R-Mutura/GPS_MODULE_ECOBODA/IMAGES/1 GPS_MODULE_V3.kicad_pro.png

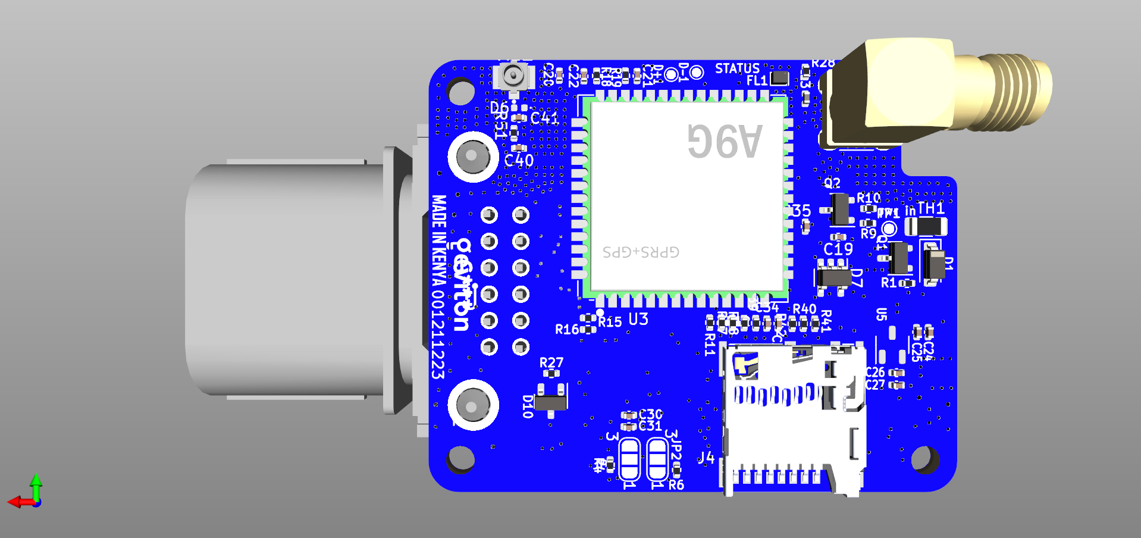
IMAGES/1 GPS_MODULE_V3.kicad_pro.png
