R-Mutura/GPS_MODULE_ECOBODA/IMAGES/2 GPS_MODULE_V3.kicad_pro.png

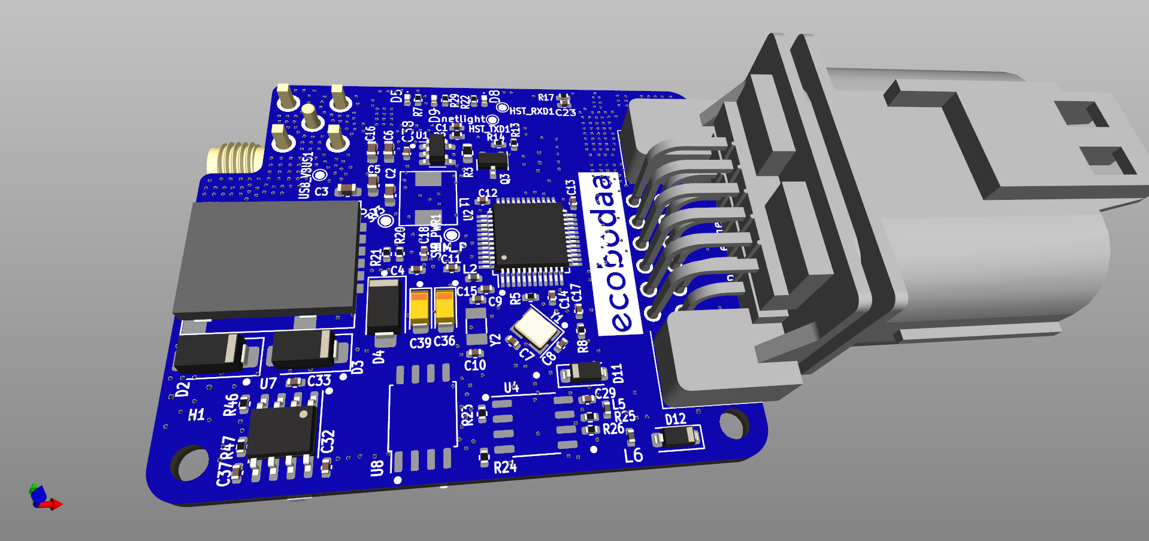
IMAGES/2 GPS_MODULE_V3.kicad_pro.png
