R-Mutura/GPS_MODULE_ECOBODA/IMAGES/GPS_MODULE_V3.kicad_pro.png

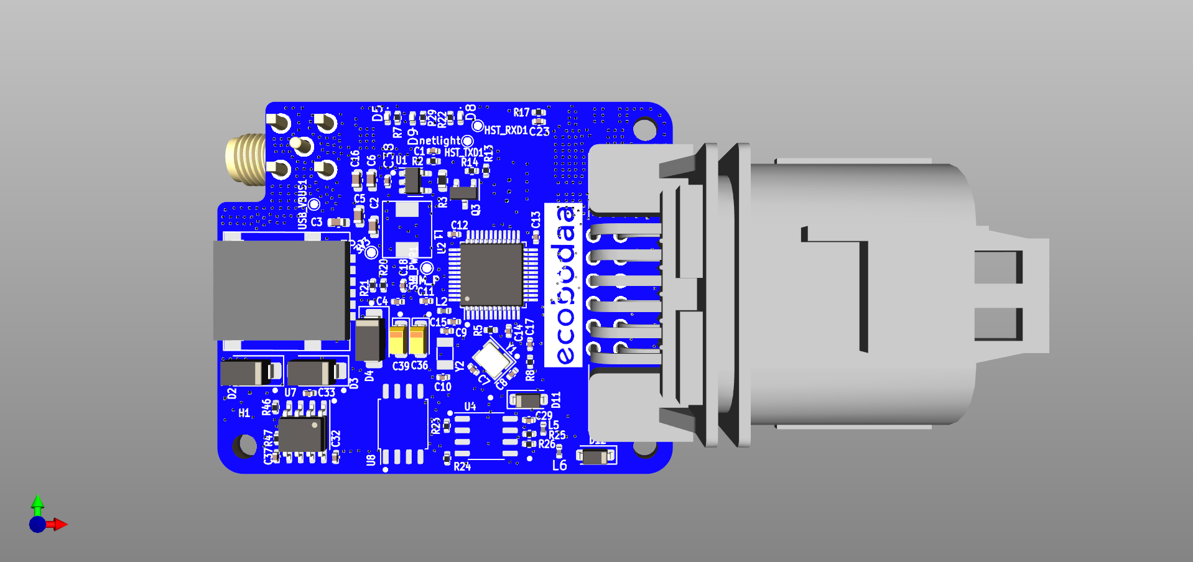
IMAGES/GPS_MODULE_V3.kicad_pro.png
