R-Mutura/GPS_MODULE_ECOBODA/SRC/GPS_MODULE_V3.kicad_pro/GPS_MODULE_V3.kicad_pro.pdf

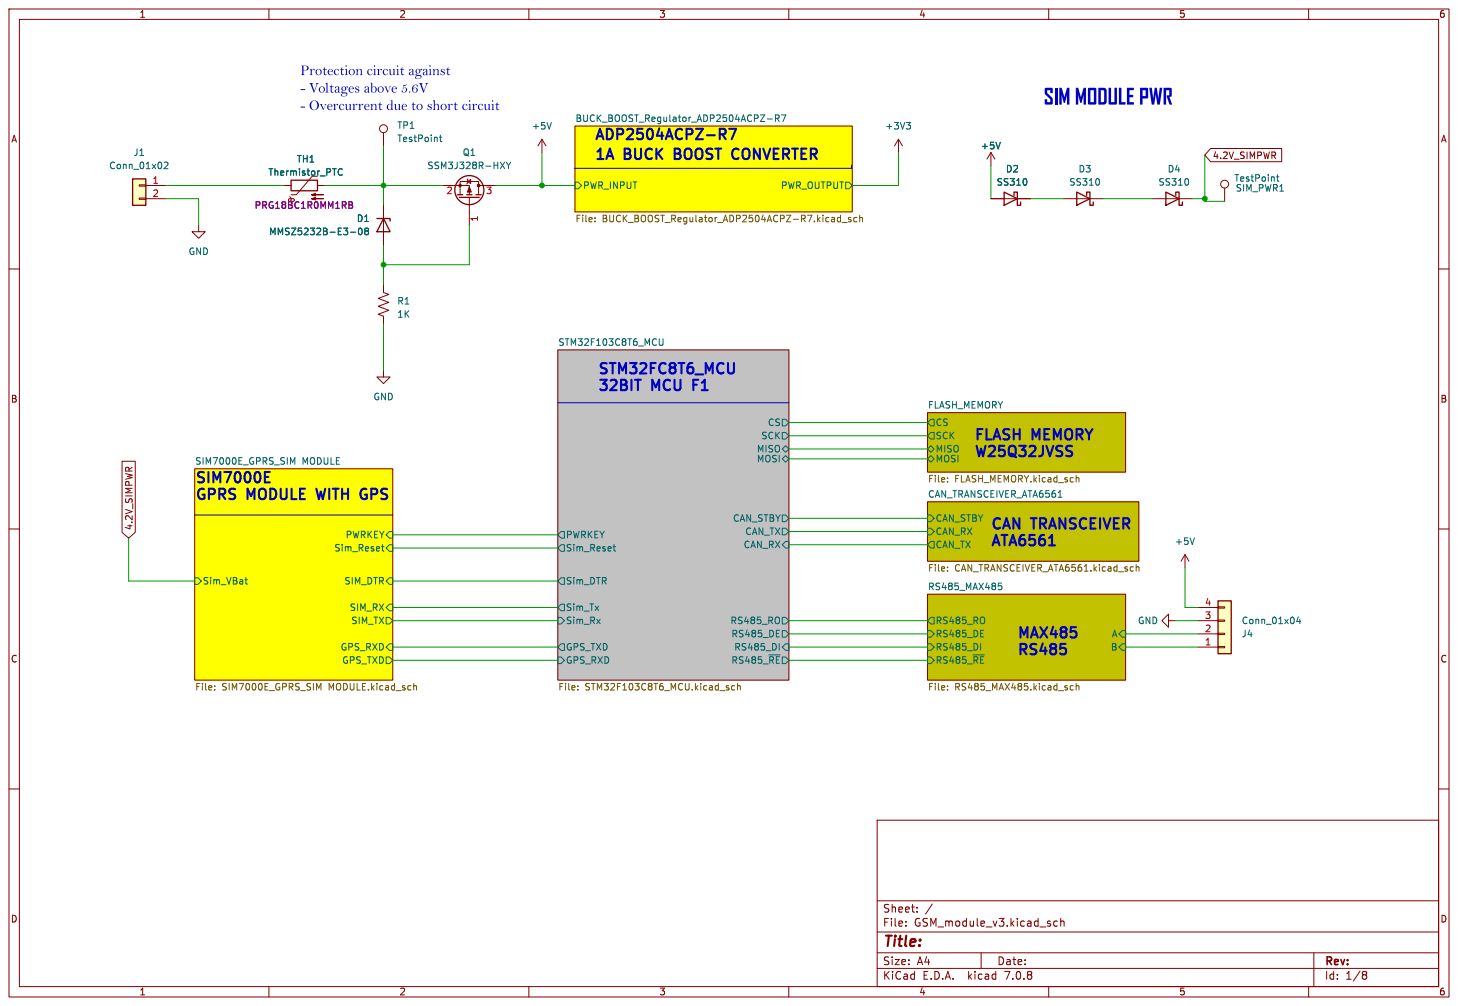
[picture p4: page 1]

Sim_VBat SIM7000E_GPRS_SIM MODULE
GPRS MODULE WITH GPS

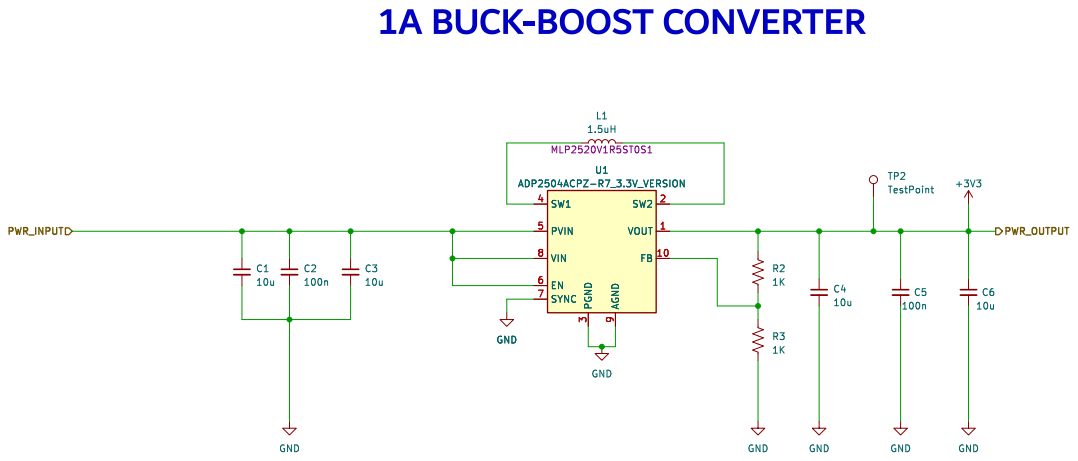
[picture p5: page 2]

3 SW1 4 PVIN 5 EN 6 SYNC 7 VIN 8 AGND

Id: 2/8 Title: File: BUCK_BOOST_Regulator_ADP2504ACPZ-R7.kicad_sch Sheet: /BUCK_BOOST_Regulator_ADP2504ACPZ-R7/

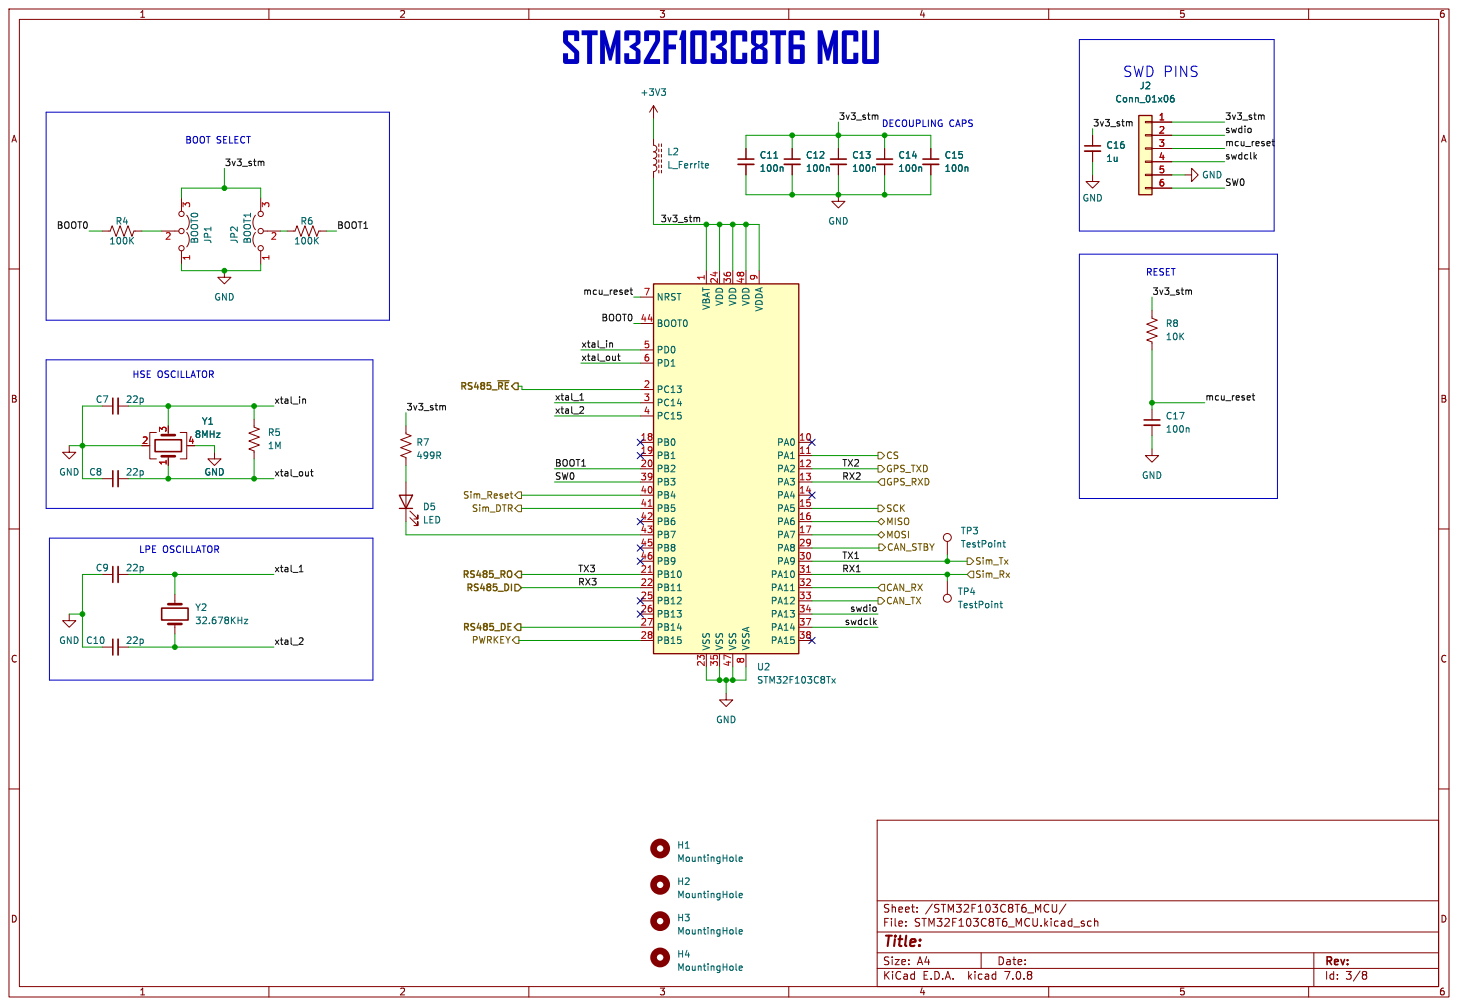
[picture p6: page 3]

1 PA0 10 PA1 11 PA2 12 PA3 13 PA4 14 PA5 15 PA6 16 PA7 17 PB0 18 PB1 19 PC13 2 PB2 20 PB10 21 PB11 22 VSS 23 VDD 24 PB12 25 PB13 26 PB14 27 PB15 28 PA8 29 PC14 3 PA9 30 PA10 31 PA11 32 PA12 33 PA13 34 VSS 35 VDD 36 PA14 37 PA15 38 PB3 39 PC15 4 PB4 40 PB5 41 PB6 42 PB7 43 BOOT0 44 PB8 45 PB9 46 VSS 47 VDD 48 PD0 5 PD1 6 NRST 7 VSSA

Id: 3/8 Title: File: STM32F103C8T6_MCU.kicad_sch Sheet: /STM32F103C8T6_MCU/ TP3 TestPoint TP4 TestPoint GND

H1 MountingHole H4 MountingHole H2 MountingHole H3 MountingHole

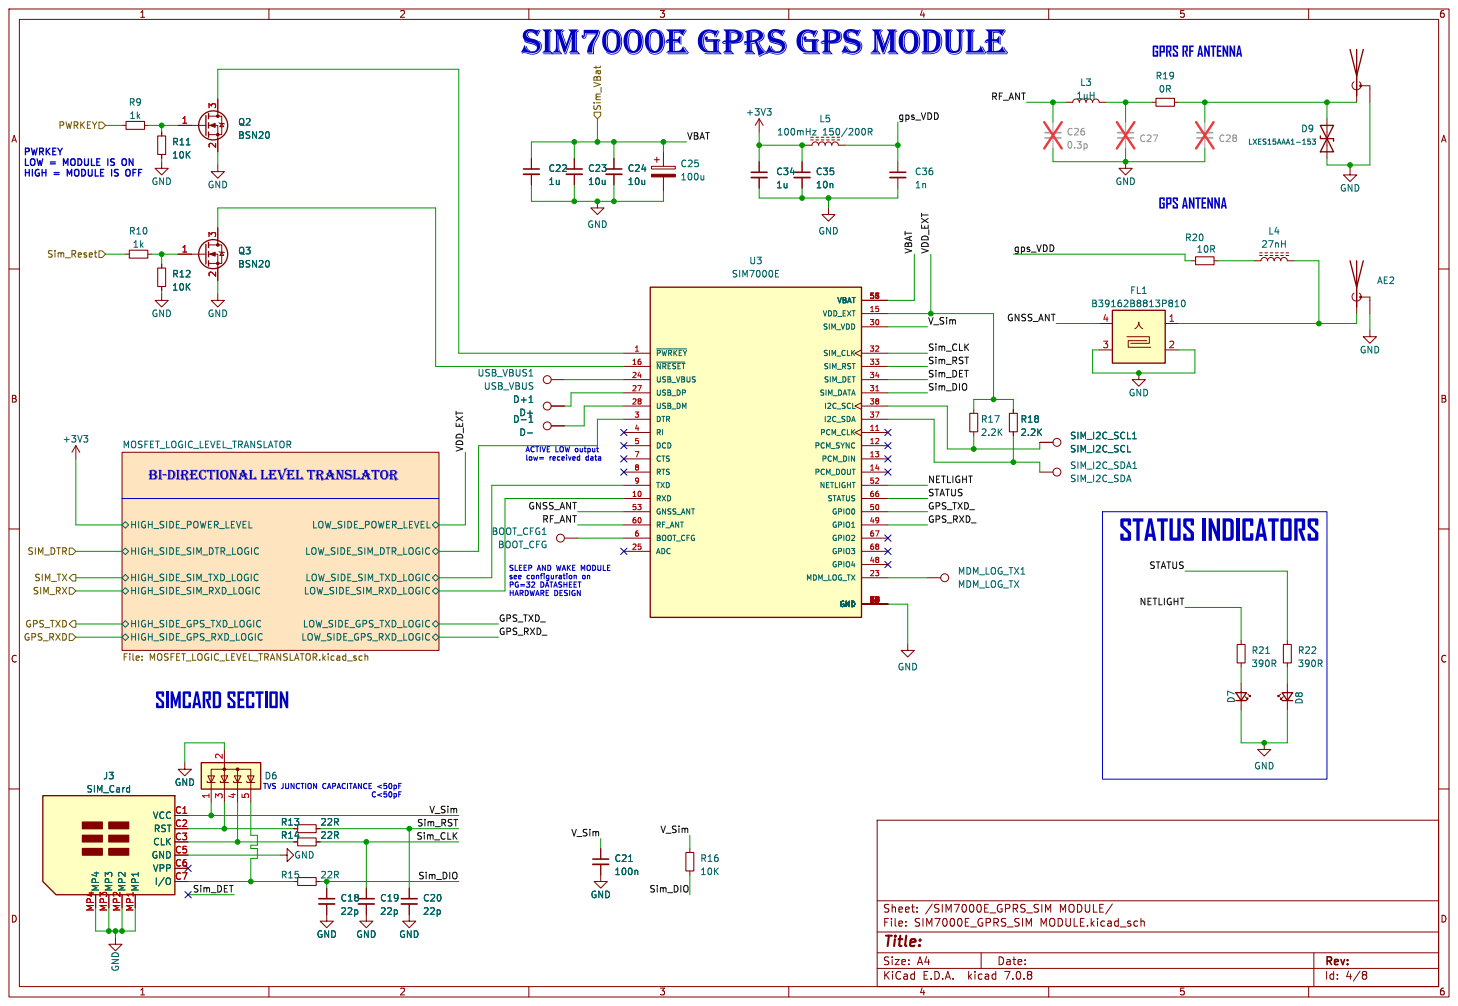
[picture p7: page 4]

low= received data SIM7000E GPRSGPSMODULE

PWRKEY
LOW = MODULE IS ON
HIGH = MODULE IS OFF

SLEEP AND WAKE MODULE

VCC C1 RST C2 CLK C3 GND C5 VPP C6

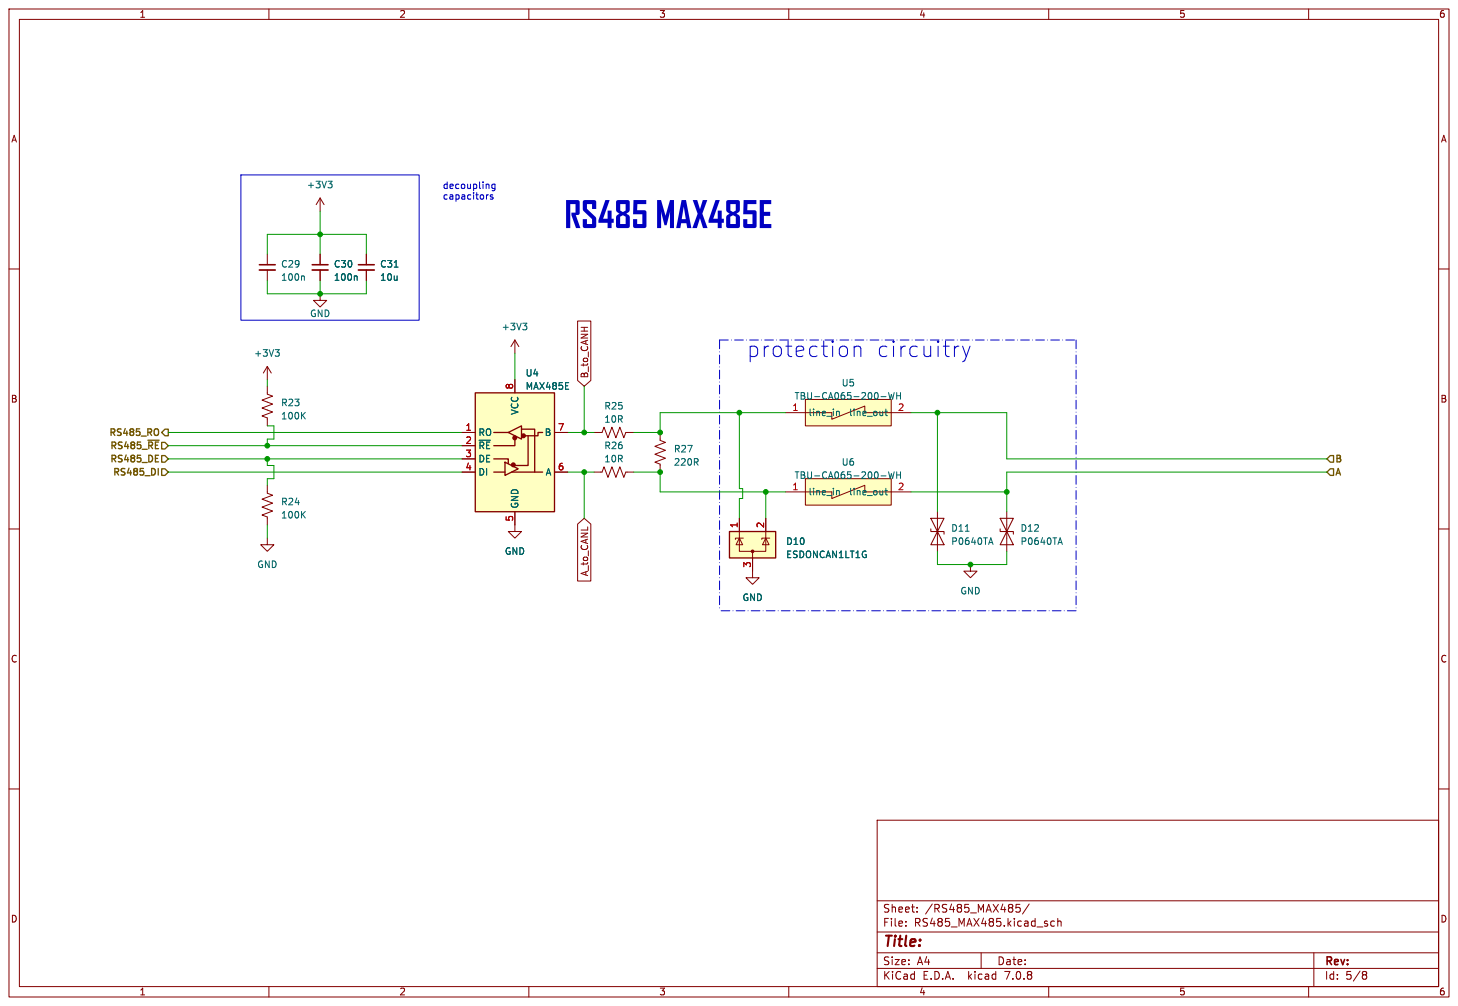
[picture p8: page 5]

Id: 5/8 Title: File: RS485_MAX485.kicad_sch Sheet: /RS485_MAX485/

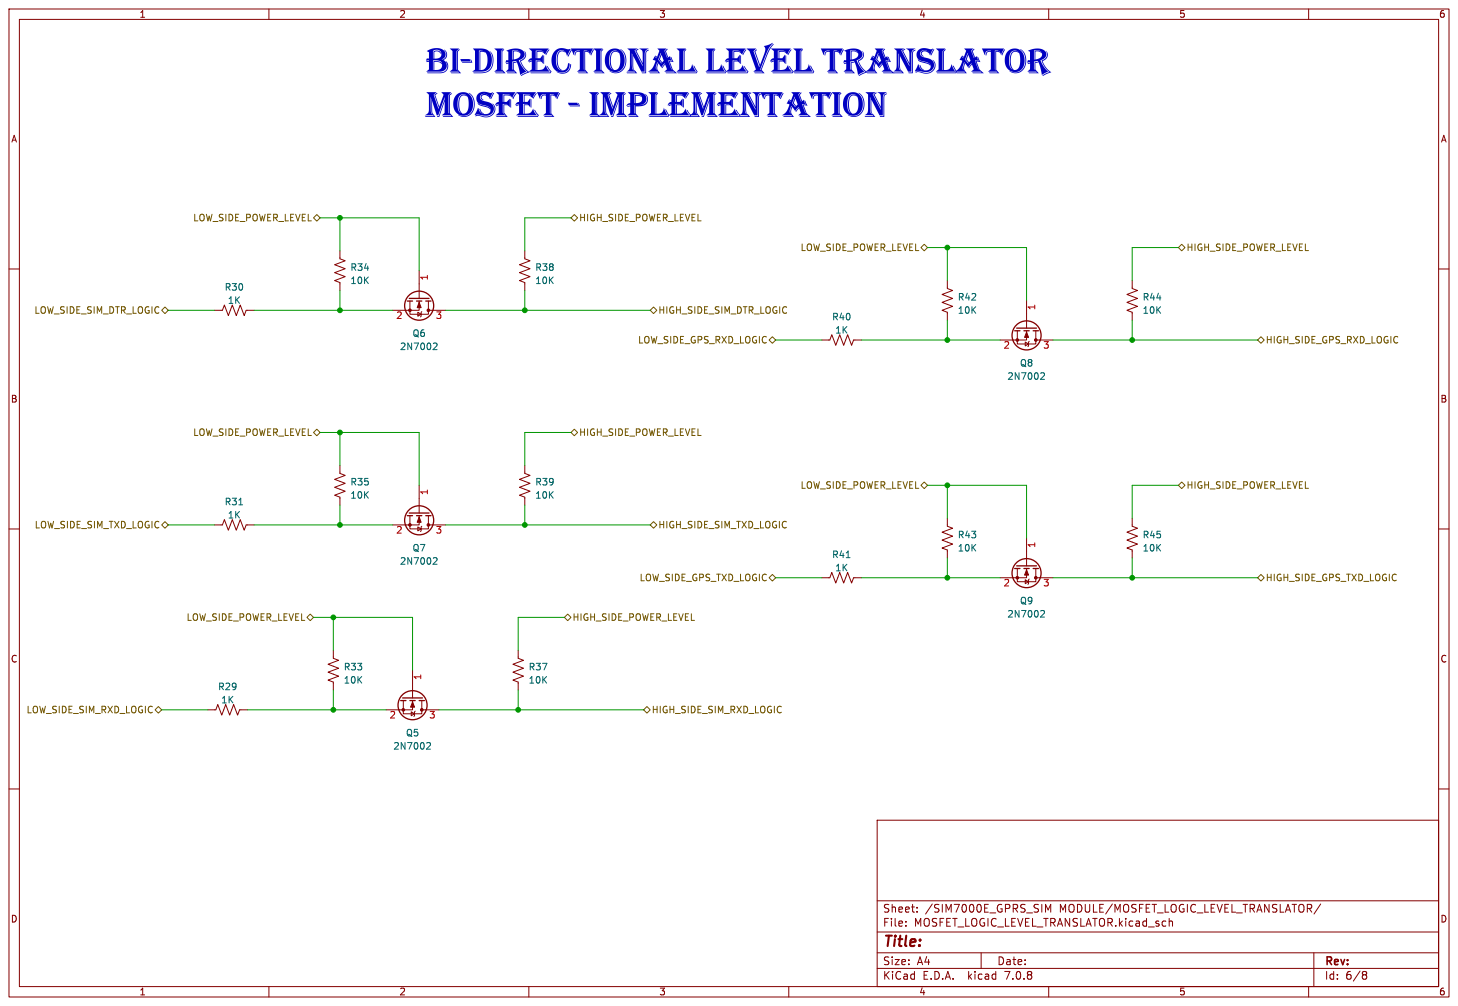
[picture p9: page 6]

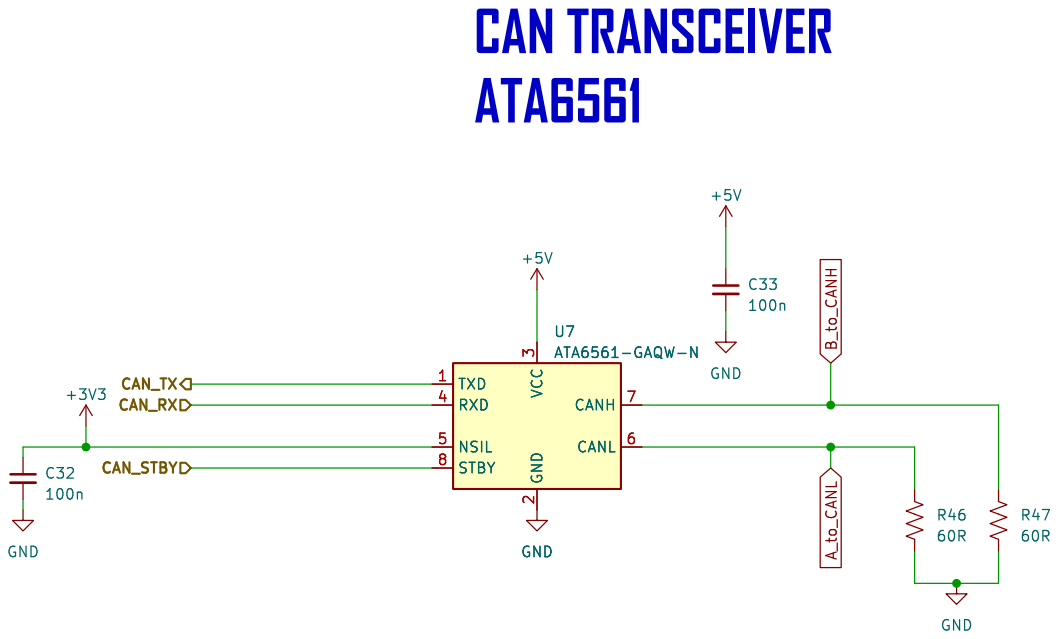
[picture p10: page 7]

3 RXD 4 NSIL 5 CANL 6 CANH 7 STBY 8 U7ATA6561-GAQW-N

3 RXD 4 NSIL 5 CANL 6 CANH 7 STBY 8 GND

Id: 7/8 Title: File: CAN_TRANSCEIVER_ATA6561.kicad_sch Sheet: /CAN_TRANSCEIVER_ATA6561/

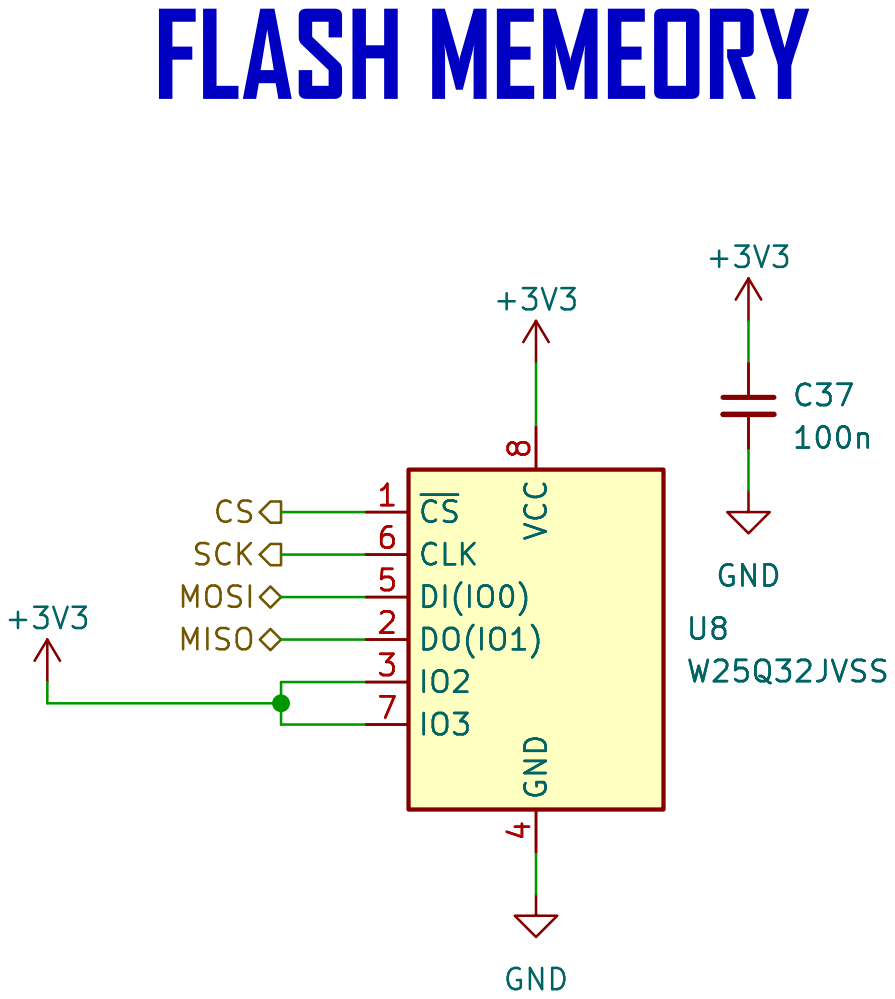
[picture p11: page 8]

Id: 8/8 Title: File: FLASH_MEMORY.kicad_sch Sheet: /FLASH_MEMORY/
