R-Mutura/GPS_MODULE_ECOBODA/SCH_PDF/BOTTOM_PLACEMENT_GUIDE_GPS.pdf

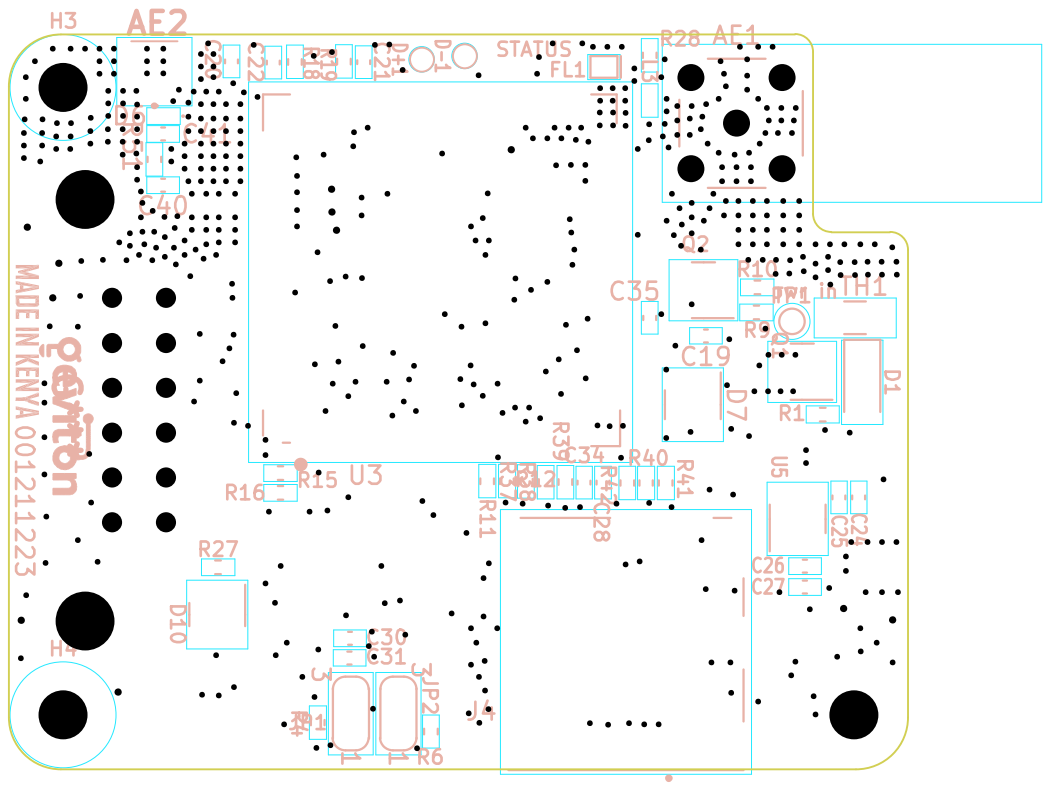
[picture p12: page 1]
