R-Mutura/GPS_MODULE_ECOBODA/SCH_PDF/TOP_PLACEMENT_GUIDE_GPS.pdf

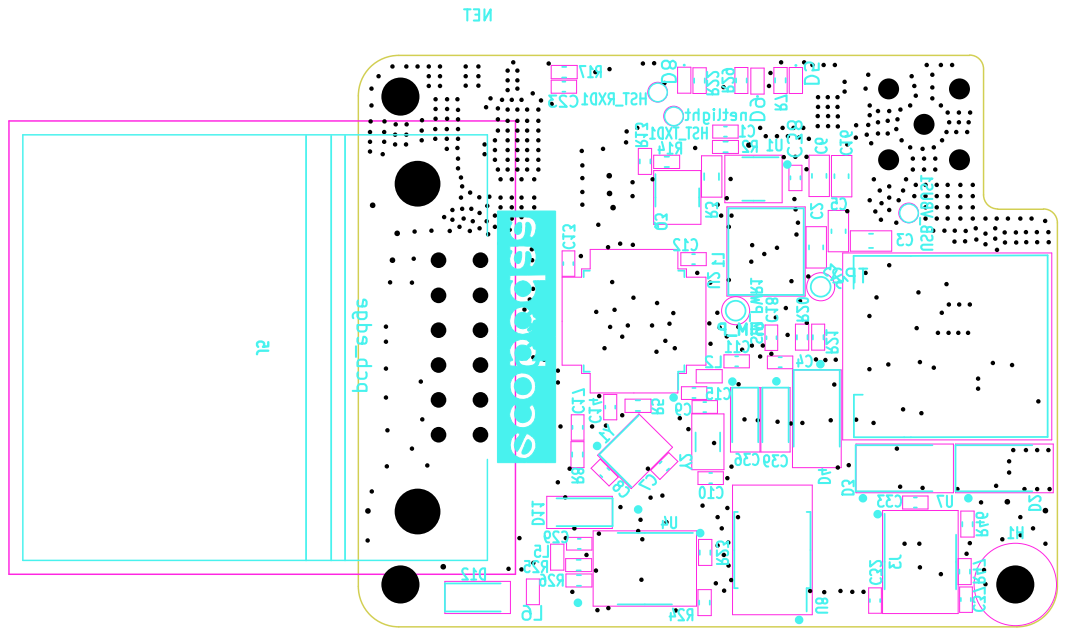
[picture p13: page 1]
