R-Mutura/GPS_MODULE_ECOBODA/SRC/GPS_MODULE_V3.kicad_pro/GPS_MODULE_V3.kicad_pro.kicad_pcb

## KiCad design SRC/GPS_MODULE_V3.kicad_pro/GPS_MODULE_V3.kicad_pro.kicad_pcb (2024-02-07)

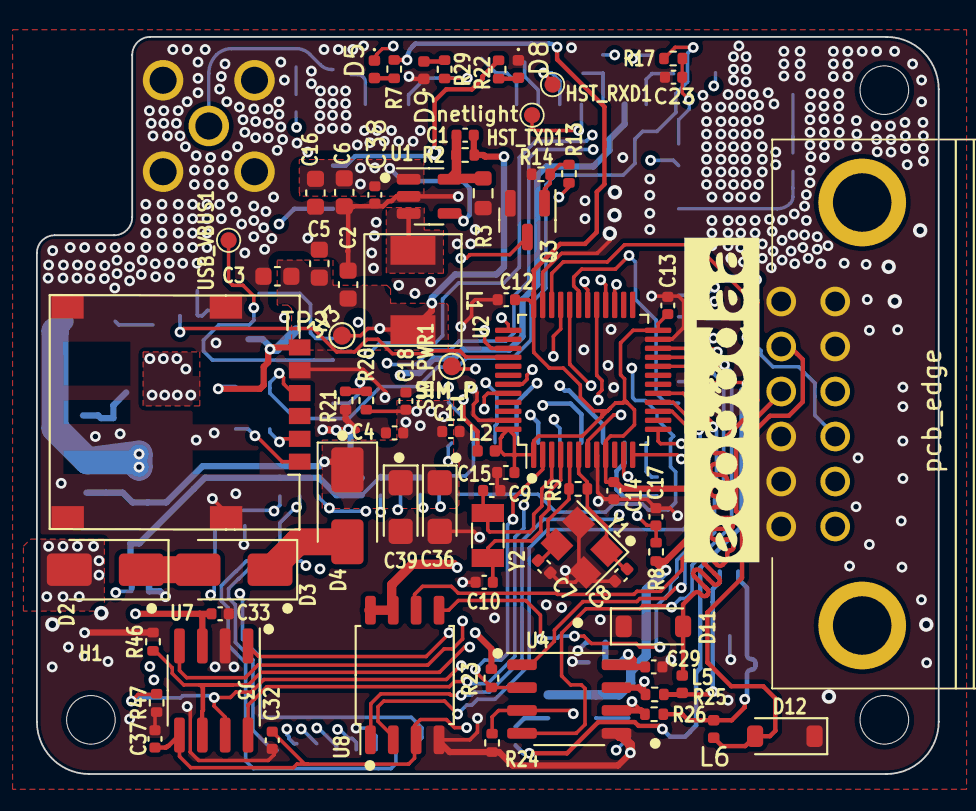
[picture p14: board GPS_MODULE_V3.kicad_pro.kicad_pcb from above]

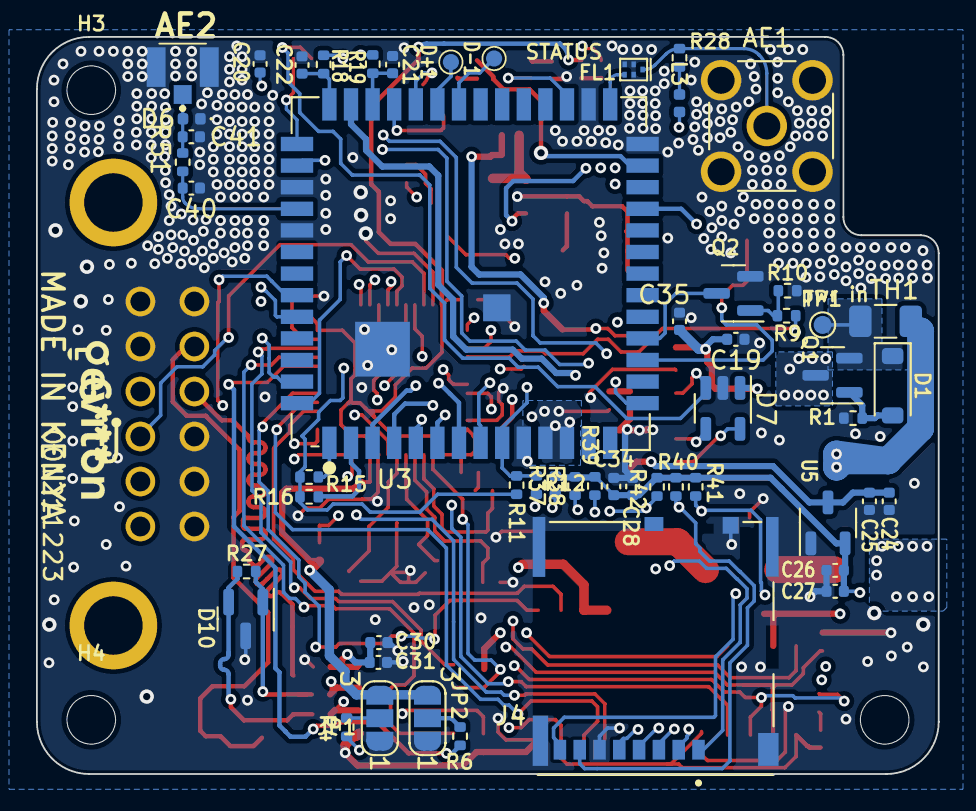
[picture p15: board GPS_MODULE_V3.kicad_pro.kicad_pcb from below]

Board: 4 copper layers, 50.1 x 41.0 mm, 128 parts (56 on the bottom side), 86 nets.

Parts:
AE1: Antenna_Shield; SMA_Molex_73251-2200_Horizontal
AE2: Antenna_Shield; UFL_COAX_CONN23370191
C1: 8.2p; C_0402_1005Metric
C2: 10n; C_0603_1608Metric
C3: 33p; C_0603_1608Metric
C4, C20, C25, C27, C34: 1u; C_0402_1005Metric
C5: 22u; C_0603_1608Metric
C6, C16: 10u; C_0603_1608Metric
C7, C8, C9, C10, C21, C22, C23: 22p; C_0402_1005Metric
C11, C18, C31: 10u; C_0402_1005Metric
C12, C13, C14, C15, C17, C29, C30, C32, C33, C35, C37, C38: 100n; C_0402_1005Metric
C19, C24, C26, C28: 0.1u; C_0402_1005Metric
C36, C39: 100u; CP_EIA-3216-18_Kemet-A
C40, C41: C_Small; C_0402_1005Metric
D1: MMSZ5232B-E3-08; D_SOD-123
D2, D3, D4: RS1K-E3/5AT; D_SMA
D5: LED; LED_0402_1005Metric
D6: LXES15AAA1-153; D_0402_1005Metric
D7: SP0504BAHT; SOT-23-5
D8: ORANGE; LED_0402_1005Metric
D9: BLUE; LED_0402_1005Metric
D10: ESDONCAN1LT1G; SOT-23
D11, D12: BEP0080MA; D_SOD-123
D+1: D+; TestPoint_Pad_D0.9mm
D-1: D-; TestPoint_Pad_D0.9mm
FL1: SAFEB1G57KE0F00R15; Filter_1411-5_1.4x1.1mm
H1, H3, H4: MountingHole; MountingHole_2.7mm
HST_RXD1: HST_RXD; TestPoint_Pad_D0.9mm
HST_TXD1: HST_TXD; TestPoint_Pad_D0.9mm
J3: nano_sim; nano_sim_NSIM-2-C
J4: Micro_SD_Card; MOLEX_503398-1892
J5: Conn_02x06_Counter_Clockwise; auto_jae_conn_02x06_p2.5mm_MX23A12NF1
JP1: BOOT0; SolderJumper-3_P1.3mm_Open_RoundedPad1.0x1.5mm_NumberLabels
JP2: BOOT1; SolderJumper-3_P1.3mm_Open_RoundedPad1.0x1.5mm_NumberLabels
L1: 2.2u; MDA5030-100M
L2, L5, L6: L_Ferrite; L_0402_1005Metric
L3: 82nH; L_0402_1005Metric
Q1: SSM3J328R-HXY; SOT-23
Q2, Q3: BSN20; SOT-23
R1: 1K; R_0402_1005Metric
R2: 180K; R_0402_1005Metric
R3: 40K; R_0603_1608Metric
R4, R6, R21, R23, R24: 100K; R_0402_1005Metric
R5: 1M; R_0402_1005Metric
R7: 499R; R_0402_1005Metric
R8, R10, R11, R14: 10K; R_0402_1005Metric
R9, R12, R13: 1k; R_0402_1005Metric
R15, R16: 2.2K; R_0402_1005Metric
R17, R18, R19, R28: 22R; R_0402_1005Metric
R20: 200K; R_0402_1005Metric
R22, R29: 390R; R_0402_1005Metric
R25, R26: 10R; R_0402_1005Metric
R27: 220R; R_0402_1005Metric
R37, R38, R39, R40, R41, R42: 10k; R_0402_1005Metric
R46, R47: 60R; R_0402_1005Metric
R51: 0R; R_0402_1005Metric
SIM_PWR1: TestPoint; TestPoint_Pad_D1.0mm
TH1: Thermistor_PTC; Fuse_1206_3216Metric
TP1, TP2: TestPoint; TestPoint_Pad_D1.0mm
U1: SY8089AAAC; SOT-23-5
U2: STM32F103C8Tx; LQFP-48_7x7mm_P0.5mm
U3: A9G_MODULE
U4: MAX485E; SOP-8_3.9x4.9mm_P1.27mm
U5: XC6206PxxxMR; SOT-23-3
U7: ATA6561-GAQW-N; SOIC-8_3.9x4.9mm_P1.27mm
U8: W25Q32JVSS; SOIC-8_5.23x5.23mm_P1.27mm
USB_VBUS1: USB_VBUS; TestPoint_Pad_D0.9mm
Y1: 8MHz; Crystal_SMD_3225-4Pin_3.2x2.5mm
Y2: 32.678KHz; Crystal_SMD_3215-2Pin_3.2x1.5mm

Connections:
2V8: C26.1, C27.1, C28.1, C34.1, J4.4 (VDD), R37.1, R38.1, R39.1, R40.1, R41.1, R42.1, U5.2 (VO)
4.2V_SIMPWR: C4.1, C11.1, C18.1, C24.1, C25.1, C36.1, C39.1, D4.1 (K), L3.2, R20.2, SIM_PWR1.1, U3.11 (VBAT), U3.12 (VBAT), U5.3 (VI)
+3V3: C1.1, C2.1, C3.1, C5.1, C29.1, C30.1, C31.1, C32.1, C37.1, L1.2, L2.1, R2.1, R23.2, TP2.1, U4.8 (VCC), U7.5 (NSIL), U8.3 (IO2), U8.7 (IO3), U8.8 (VCC)
+5V: C33.1, J5.12, TH1.1, U7.3 (VCC)
/5V_FILTERED_: C6.1, C16.1, C38.1, D2.2 (A), Q1.3 (D), U1.1 (EN), U1.4 (IN)
/A9G_GSM_GPRS_MODULE/GPRS_NET-STATUS: R22.1, U3.26 (IO27)
/A9G_GSM_GPRS_MODULE/GPS POSITION: R29.1, U3.30 (IO28)
/A9G_GSM_GPRS_MODULE/IO29: R12.1, U3.24 (IO29)
/A9G_GSM_GPRS_MODULE/PWRKEY: R13.1, U2.28 (PB15)
/A9G_GSM_GPRS_MODULE/Sim_CLK: C22.1, R18.1, U3.41 (SIM_CLK)
/A9G_GSM_GPRS_MODULE/Sim_DIO: C21.1, R19.1, U3.39 (SIM_DIO)
/A9G_GSM_GPRS_MODULE/Sim_RST: C23.1, R17.1, U3.42 (SIM_RST)
/A9G_GSM_GPRS_MODULE/Sim_Restart: R9.1, U2.40 (PB4)
/A9G_GSM_GPRS_MODULE/TF_CARD_CONN/SD_CLK: J4.5 (CLK), R42.2, U3.8 (SD_CLK/SPI1_CLK/I2C1_SCL/IO8)
/A9G_GSM_GPRS_MODULE/TF_CARD_CONN/SD_CMD: J4.3 (CMD), R39.2, U3.7 (SD_CMD/SPI1_SC0/I2C1_SDA/IO9)
/A9G_GSM_GPRS_MODULE/TF_CARD_CONN/SD_D0: J4.7 (DAT0), R40.2, U3.6 (SD_D0/SPI1_CSI/IO10)
/A9G_GSM_GPRS_MODULE/TF_CARD_CONN/SD_D1: J4.8 (DAT1), R41.2, U3.5 (SD_D1/SPI1_D0/IO11)
/A9G_GSM_GPRS_MODULE/TF_CARD_CONN/SD_D2: J4.1 (DAT2), R37.2, U3.4 (SD_D2/SPI1_DI/IO12)
/A9G_GSM_GPRS_MODULE/TF_CARD_CONN/SD_D3: J4.2 (DAT3/CD), R38.2, U3.3 (SD_D3/IO13)
/A9G_GSM_GPRS_MODULE/VIO: C20.1, R11.2, R15.2, R16.2, U3.43 (VIO)
/A9G_GSM_GPRS_MODULE/V_Sim: C19.2, C35.1, D7.1 (K), J3.C1 (VCC), U3.40 (VSIM)
/CAN_TRANSCEIVER_ATA6561/CAN_RX: U2.32 (PA11), U7.4 (RXD)
/CAN_TRANSCEIVER_ATA6561/CAN_STBY: U2.29 (PA8), U7.8 (STBY)
/CAN_TRANSCEIVER_ATA6561/CAN_TX: U2.33 (PA12), U7.1 (TXD)
/FLASH_MEMORY/CS: U2.11 (PA1), U8.1 (~CS)
/FLASH_MEMORY/MISO: U2.16 (PA6), U8.2 (DO(IO1))
/FLASH_MEMORY/MOSI: U2.17 (PA7), U8.5 (DI(IO0))
/FLASH_MEMORY/SCK: U2.15 (PA5), U8.6 (CLK)
/RS485_MAX485/A: D12.2 (A2), J5.2, L6.2
/RS485_MAX485/B: D11.2 (A2), J5.3, L5.2
/RS485_MAX485/RS485_DE: R24.2, U2.27 (PB14), U4.3 (DE)
/RS485_MAX485/RS485_~RE: R23.1, U2.2 (PC13), U4.2 (~RE)
/STM32F103C8T6_MCU/3v3_stm: C12.1, C13.1, C14.1, C15.1, JP1.3 (B), JP2.3 (B), L2.2, R7.1, R8.1, U2.1 (VBAT), U2.9 (VDDA), U2.24 (VDD), U2.36 (VDD), U2.48 (VDD)
/STM32F103C8T6_MCU/BOOT0: R4.1, U2.44 (BOOT0)
/STM32F103C8T6_MCU/BOOT1: R6.2, U2.20 (PB2)
/STM32F103C8T6_MCU/RX1: U2.31 (PA10), U3.54 (UART1_TXD/IO1)
/STM32F103C8T6_MCU/RX2: U2.13 (PA3), U3.49 (UART2_TXD/IO4)
/STM32F103C8T6_MCU/RX3: U2.22 (PB11), U4.1 (RO)
/STM32F103C8T6_MCU/SW0: J5.11, U2.39 (PB3)
/STM32F103C8T6_MCU/TX1: U2.30 (PA9), U3.53 (UART1_RXD/IO0)
/STM32F103C8T6_MCU/TX2: U2.12 (PA2), U3.50 (UART2_RXD/IO5)
/STM32F103C8T6_MCU/TX3: U2.21 (PB10), U4.4 (DI)
/STM32F103C8T6_MCU/mcu_reset: C17.1, R8.2, U2.7 (NRST)
/STM32F103C8T6_MCU/swdclk: J5.9, U2.37 (PA14)
/STM32F103C8T6_MCU/swdio: J5.10, U2.34 (PA13)
/STM32F103C8T6_MCU/xtal_1: C9.2, U2.3 (PC14), Y2.2
/STM32F103C8T6_MCU/xtal_2: C10.2, U2.4 (PC15), Y2.1
/STM32F103C8T6_MCU/xtal_in: C7.2, R5.1, U2.5 (PD0), Y1.3
/STM32F103C8T6_MCU/xtal_out: C8.2, R5.2, U2.6 (PD1), Y1.1
A_to_CANL: R26.1, R46.1, U4.6 (A), U7.6 (CANL)
B_to_CANH: R25.1, R47.1, U4.7 (B), U7.7 (CANH)
GND: AE1.2 (Shield), AE2.2 (Shield), C2.2, C3.2, C4.2, C5.2, C6.2, C7.1, C8.1, C9.1, C10.1, C11.2, C12.2, C13.2, C14.2, C15.2, C16.2, C17.2, C18.2, C19.1, C20.2, C21.2, C22.2, C23.2, C24.2, C25.2, C26.2, C27.2, C28.2, C29.2, C30.2, C31.2, C32.2, C33.2, C34.2, C35.2, C36.2, C37.2, C38.2, C39.2, C40.1, C41.1, D6.1 (A1), D7.2 (A), D8.1 (K), D9.1 (K), D10.3 (A), D11.1 (A1), D12.1 (A1), FL1.2, FL1.3, FL1.5, J3.C5 (GND), J3.MP1, J4.6 (VSS), J4.9 (SHIELD), J5.1, J5.4, J5.5, J5.6, J5.7, J5.8, JP1.1 (A), JP2.1 (A), Q2.2 (S), Q3.2 (S), R1.2, R3.2, R10.1, R14.1, R21.1, R24.1, R46.2, R47.2, U1.2 (GND), U2.8 (VSSA), U2.23 (VSS), U2.35 (VSS), U2.47 (VSS), U3.10 (GND), U3.27 (GND), U3.29 (GND), U3.44 (GND), U3.46 (GND), U3.55 (GND), U3.56 (GND), U4.5 (GND), U5.1 (GND), U7.2 (GND), U8.4 (GND), Y1.2, Y1.4
unnamed: AE1.1 (A), FL1.1, R28.2
unnamed: AE2.1 (A), C41.2, D6.2 (A2), R51.2
unnamed: D1.2 (A), Q1.1 (G), R1.1
unnamed: D1.1 (K), Q1.2 (S), TH1.2, TP1.1
unnamed: D2.1 (K), D3.2 (A)
unnamed: D3.1 (K), D4.2 (A)
unnamed: D5.2 (A), R7.2
unnamed: D5.1 (K), U2.43 (PB7)
unnamed: D8.2 (A), R22.2
unnamed: D9.2 (A), R29.2
unnamed: D10.1 (K), L5.1, R25.2, R27.2
unnamed: D10.2 (K), L6.1, R26.2, R27.1
unnamed: D7.4 (K), J3.C3 (CLK), R18.2
unnamed: D7.5 (K), J3.C7 (I/O), R19.2
unnamed: D7.3 (K), J3.C2 (RST), R17.2
unnamed: JP1.2 (C), R4.2
unnamed: JP2.2 (C), R6.1
unnamed: L3.1, R28.1
unnamed: Q2.3 (D), U3.18 (RESET)
unnamed: Q2.1 (G), R9.2, R10.2
unnamed: Q3.3 (D), R11.1, R12.2, U3.9 (PWR_KEY)
unnamed: Q3.1 (G), R13.2, R14.2
unnamed: C1.2, R2.2, R3.1, U1.5 (FB)
unnamed: L1.1, U1.3 (LX)
unnamed: R20.1, R21.2, U3.15 (ADC0)
unnamed: FL1.4, U3.28 (GPS_RF)
unnamed: C40.2, R51.1, U3.45 (GSM_RF)
unnamed: HST_TXD1.1, U3.38 (HST_RXD)
unnamed: HST_RXD1.1, U3.37 (HST_TXD)
unnamed: R15.1, U3.1 (I2C2_SCL/IO19)
unnamed: R16.1, U3.2 (I2C2_SDA/IO20)
unnamed: D-1.1, U3.35 (USB_N)
unnamed: D+1.1, U3.36 (USB_P)
unnamed: U3.17 (VUSB_DET), USB_VBUS1.1
