R-Mutura/GPS_MODULE_ECOBODA/src/GSM_module_v3.kicad_sch

## KiCad design src/GSM_module_v3.kicad_sch (2023-12-09)

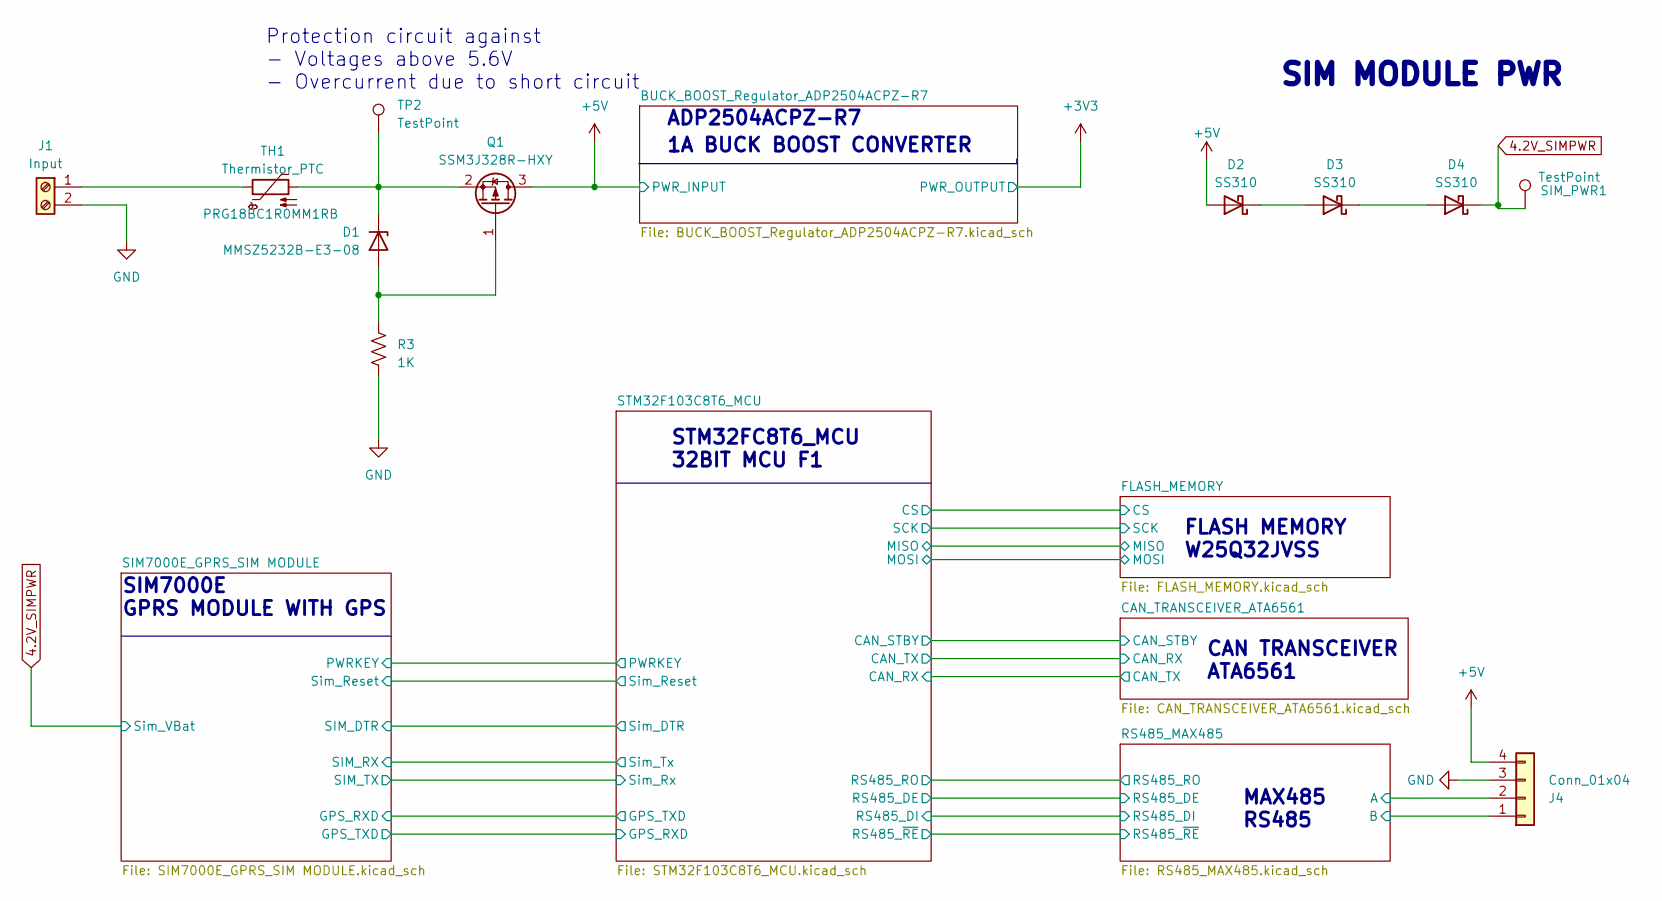
[picture p16: schematic GSM_module_v3.kicad_sch]

Parts:
D1: MMSZ5232B-E3-08; D_SOD-123
D2, D3, D4: SS310; D_SMA
J1: Input; TerminalBlock_Phoenix_PT-1,5-2-3.5-H_1x02_P3.50mm_Horizontal
J4: Conn_01x04
Q1: SSM3J328R-HXY; SOT-23
R3: 1K; R_0402_1005Metric
SIM_PWR1: TestPoint; TestPoint_Pad_D1.0mm
TH1: Thermistor_PTC; Fuse_0603_1608Metric_Pad1.05x0.95mm_HandSolder; MPN PRG18BC1R0MM1RB
TP2: TestPoint; TestPoint_Pad_D1.0mm

Connections:
4.2V_SIMPWR: D4.1 (K), SIM_PWR1.1
+5V: D2.2 (A), J4.4, Q1.3 (D)
A: J4.2
B: J4.1
GND: J1.2, J4.3, R3.2
unnamed: D1.1 (K), Q1.2 (S), TH1.2, TP2.1
unnamed: D1.2 (A), Q1.1 (G), R3.1
unnamed: D2.1 (K), D3.2 (A)
unnamed: D3.1 (K), D4.2 (A)
unnamed: J1.1, TH1.1

Notes on the sheet:
FLASH MEMORY W25Q32JVSS
ADP2504ACPZ-R7
1A BUCK BOOST CONVERTER
STM32FC8T6_MCU 32BIT MCU F1
MAX485 RS485
SIM MODULE PWR
CAN TRANSCEIVER ATA6561
Protection circuit against - Voltages above 5.6V - Overcurrent due to short circuit
SIM7000E GPRS MODULE WITH GPS
