R-Mutura/GPS_MODULE_ECOBODA/(commit log)

2023-12-10 layut completed
    [BUCK_BOOST_Regulator_ADP2504ACPZ-R7.kicad_sch, CAN_TRANSCEIVER_ATA6561.kicad_sch, FLASH_MEMORY.kicad_sch, GPS_MODULE_V3.kicad_pcb, GPS_MODULE_V3.kicad_sch, GSM_module_v3.kicad_pcb, MOSFET_LOGIC_LEVEL_TRANSLATOR.kicad_sch, RS485_MAX485.kicad_sch]
2023-12-12 all items updated production ready
    [BUCK_BOOST_Regulator_ADP2504ACPZ-R7.kicad_sch, CAN_TRANSCEIVER_ATA6561.kicad_sch, FLASH_MEMORY.kicad_sch, GPS_MODULE_V3.kicad_pcb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]
2023-12-12 added logo
    [GPS_MODULE_V3.kicad_pro-B_Cu.gbr, GPS_MODULE_V3.kicad_pro-B_Mask.gbr, GPS_MODULE_V3.kicad_pro-B_Paste.gbr, GPS_MODULE_V3.kicad_pro-B_Silkscreen.gbr, GPS_MODULE_V3.kicad_pro-Edge_Cuts.gbr, GPS_MODULE_V3.kicad_pro-F_Cu.gbr, GPS_MODULE_V3.kicad_pro-F_Mask.gbr, GPS_MODULE_V3.kicad_pro-F_Paste.gbr]
2023-12-12 gps update on buck 3v3
    [GPS_MODULE_V3.kicad_pro-B_Cu.gbr, GPS_MODULE_V3.kicad_pro-B_Mask.gbr, GPS_MODULE_V3.kicad_pro-B_Paste.gbr, GPS_MODULE_V3.kicad_pro-B_Silkscreen.gbr, GPS_MODULE_V3.kicad_pro-Edge_Cuts.gbr, GPS_MODULE_V3.kicad_pro-F_Cu.gbr, GPS_MODULE_V3.kicad_pro-F_Mask.gbr, GPS_MODULE_V3.kicad_pro-F_Paste.gbr]
2023-12-12 BOM updates
    [GPS_MODULE_V3.kicad_pro.csv, GPS_MODULE_V3.kicad_pro.kicad_sch, GPS_MODULE_V3_BOM.xlsx]
2024-01-16 updates on BOM, CPL and gerbers
    [A9G_GSM_GPRS_MODULE.kicad_sch, GPS_MODULE_V3.kicad_pro.csv, GPS_MODULE_V3.kicad_pro.kicad_pcb, GPS_MODULE_V3.kicad_pro.kicad_sch, GPS_MODULE_V3_BOM.xlsx, MOSFET_LOGIC_LEVEL_TRANSLATOR.kicad_sch, RS485_MAX485.kicad_sch, STM32F103C8T6_MCU.kicad_sch]
2024-01-19 completed GPS
    [A9G_GSM_GPRS_MODULE.kicad_sch, FLASH_MEMORY.kicad_sch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]
2024-01-20 fiducial, resistor and markings
2024-01-23 completed GPS ecoboda files
    [A9G_GSM_GPRS_MODULE.kicad_sch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]
2024-01-23 update removal of all level shifts diodes
    [A9G_GSM_GPRS_MODULE.kicad_sch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]
2024-02-07 GPS all files BOM and placemnt guide files added
    [A9G_GSM_GPRS_MODULE.kicad_sch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]
